daisyaudio/Seed3-DevKit-Pedal/pcb/ES-Seed3-DevKit-Pedal-Rev4/ES-Seed3-DevKit-Pedal-Rev4.kicad_pcb

## KiCad design pcb/ES-Seed3-DevKit-Pedal-Rev4/ES-Seed3-DevKit-Pedal-Rev4.kicad_pcb (2026-06-25)

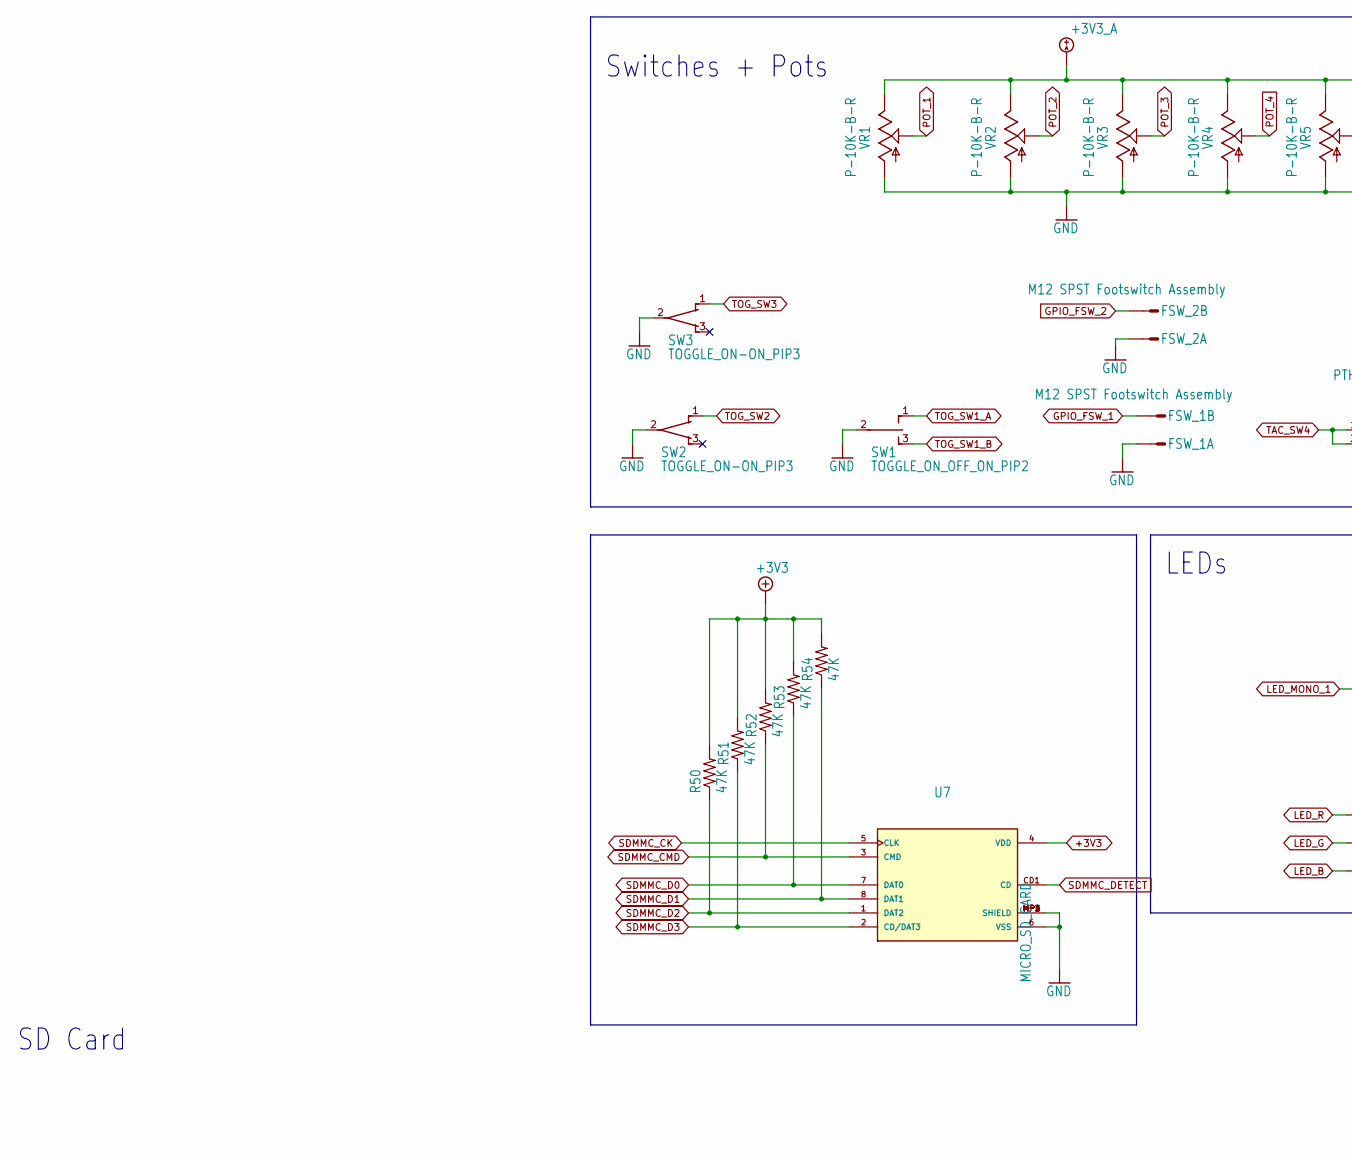
[picture p1: schematic ES-Seed3-DevKit-Pedal-Rev1_2.kicad_sch, part in row 1, column 1]

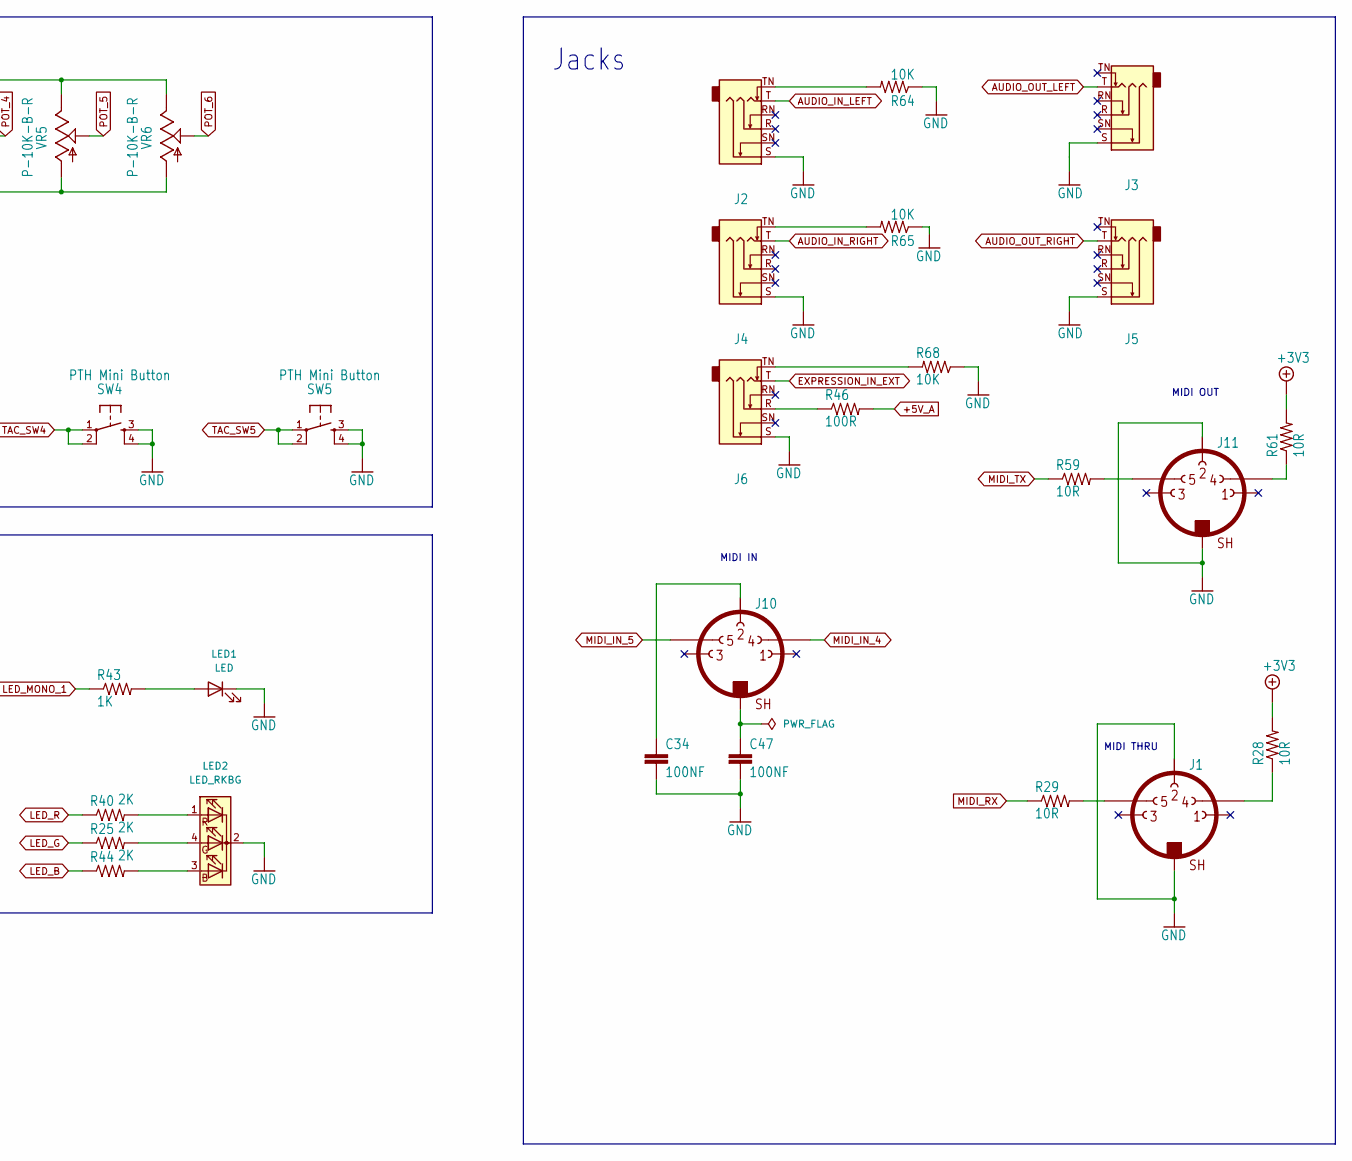
[picture p2: schematic ES-Seed3-DevKit-Pedal-Rev1_2.kicad_sch, part in row 1, column 2]

Parts:
C34, C47: 100NF; C_0603_1608Metric
FSW_1, FSW_2: M12 SPST Footswitch Assembly; S02P
J1, J10, J11: DIN_MIDI_5P; 57PC5F
J2, J3, J4, J5, J6: JACK_TRS_SWITCHING; Jack_6.35mm_Neutrik_NMJ6HCD2_Horizontal
LED1: LED; LED_D5.0mm
LED2: LED_RKBG; LED_D5.0mm-4_RGB_Wide_Pins
R25, R40, R44: 2K; R_0603_1608Metric
R28, R29, R59, R61: 10R; R_0603_1608Metric
R43: 1K; R_0603_1608Metric
R46: 100R; R_0603_1608Metric
R50, R51, R52, R53, R54: 47K; R_0603_1608Metric
R64, R65, R68: 10K; R_0603_1608Metric
SW1: TOGGLE_ON_OFF_ON_PIP2; TOGGLE_ON_OFF_ON
SW2, SW3: TOGGLE_ON-ON_PIP3; TOGGLE_ON_ON_2
SW4, SW5: PTH Mini Button; TL1105SPF250Q_SILK
U7: MICRO_SD_CARD; TF-01A
VR1, VR2, VR3, VR4, VR5, VR6: P-10K-B-R; 9MM_SNAP-IN_POT_SILK

Connections:
+3V3: R28.2, R50.2, R51.2, R52.2, R53.2, R54.2, R61.2, U7.4 (VDD); also elsewhere on the board
+3V3_A: VR1.3, VR2.3, VR3.3, VR4.3, VR5.3, VR6.3; also elsewhere on the board
+5V_A: R46.2; also elsewhere on the board
AUDIO_IN_LEFT: J2.T; also elsewhere on the board
AUDIO_IN_RIGHT: J4.T; also elsewhere on the board
AUDIO_OUT_LEFT: J3.T; also elsewhere on the board
AUDIO_OUT_RIGHT: J5.T; also elsewhere on the board
EXPRESSION_IN_EXT: J6.T; also elsewhere on the board
GND: C34.2, C47.2, FSW_1.1 (S), FSW_2.1 (S), J1.GND1 (PE), J1.GND2 (PE), J1.P2 (2), J2.S, J3.S, J4.S, J5.S, J6.S, J11.GND1 (PE), J11.GND2 (PE), J11.P2 (2), LED1.1 (K), LED2.2 (K), R64.1, R65.1, R68.1, SW1.2, SW2.2, SW3.2, SW4.3, SW4.4, SW5.3, SW5.4, U7.6 (VSS), U7.MP1 (SHIELD), U7.MP2 (SHIELD), U7.MP3 (SHIELD), U7.MP4 (SHIELD), VR1.1, VR2.1, VR3.1, VR4.1, VR5.1, VR6.1; also elsewhere on the board
GPIO_FSW_1: FSW_1.2 (S); also elsewhere on the board
GPIO_FSW_2: FSW_2.2 (S); also elsewhere on the board
LED_B: R44.1; also elsewhere on the board
LED_G: R25.1; also elsewhere on the board
LED_MONO_1: R43.1; also elsewhere on the board
LED_R: R40.1; also elsewhere on the board
MIDI_IN_4: J10.P4 (4); also elsewhere on the board
MIDI_IN_5: J10.P5 (5); also elsewhere on the board
MIDI_RX: R29.1; also elsewhere on the board
MIDI_TX: R59.1; also elsewhere on the board
unnamed: C47.1, J10.GND1 (PE), J10.GND2 (PE)
unnamed: J1.P4 (4), R28.1
unnamed: J1.P5 (5), R29.2
unnamed: J2.TN, R64.2
unnamed: J4.TN, R65.2
unnamed: J6.R, R46.1
unnamed: J6.TN, R68.2
unnamed: C34.1, J10.P2 (2)
unnamed: J11.P4 (4), R61.1
unnamed: J11.P5 (5), R59.2
unnamed: LED1.2 (A), R43.2
unnamed: LED2.3 (BA), R44.2
unnamed: LED2.4 (GA), R25.2
unnamed: LED2.1 (RA), R40.2
POT_1: VR1.2; also elsewhere on the board
POT_2: VR2.2; also elsewhere on the board
POT_3: VR3.2; also elsewhere on the board
POT_4: VR4.2; also elsewhere on the board
POT_5: VR5.2; also elsewhere on the board
POT_6: VR6.2; also elsewhere on the board
SDMMC_CK: U7.5 (CLK); also elsewhere on the board
SDMMC_CMD: R52.1, U7.3 (CMD); also elsewhere on the board
SDMMC_D0: R53.1, U7.7 (DAT0); also elsewhere on the board
SDMMC_D1: R54.1, U7.8 (DAT1); also elsewhere on the board
SDMMC_D2: R50.1, U7.1 (DAT2); also elsewhere on the board
SDMMC_D3: R51.1, U7.2 (CD/DAT3); also elsewhere on the board
SDMMC_DETECT: U7.CD1 (CD); also elsewhere on the board
TAC_SW4: SW4.1, SW4.2; also elsewhere on the board
TAC_SW5: SW5.1, SW5.2; also elsewhere on the board
TOG_SW1_A: SW1.1 (O); also elsewhere on the board
TOG_SW1_B: SW1.3 (S); also elsewhere on the board
TOG_SW2: SW2.1 (O); also elsewhere on the board
TOG_SW3: SW3.1 (O); also elsewhere on the board

Notes on the sheet:
MIDI IN
Jacks
MIDI OUT
Switches + Pots
LEDs
MIDI THRU
SD Card

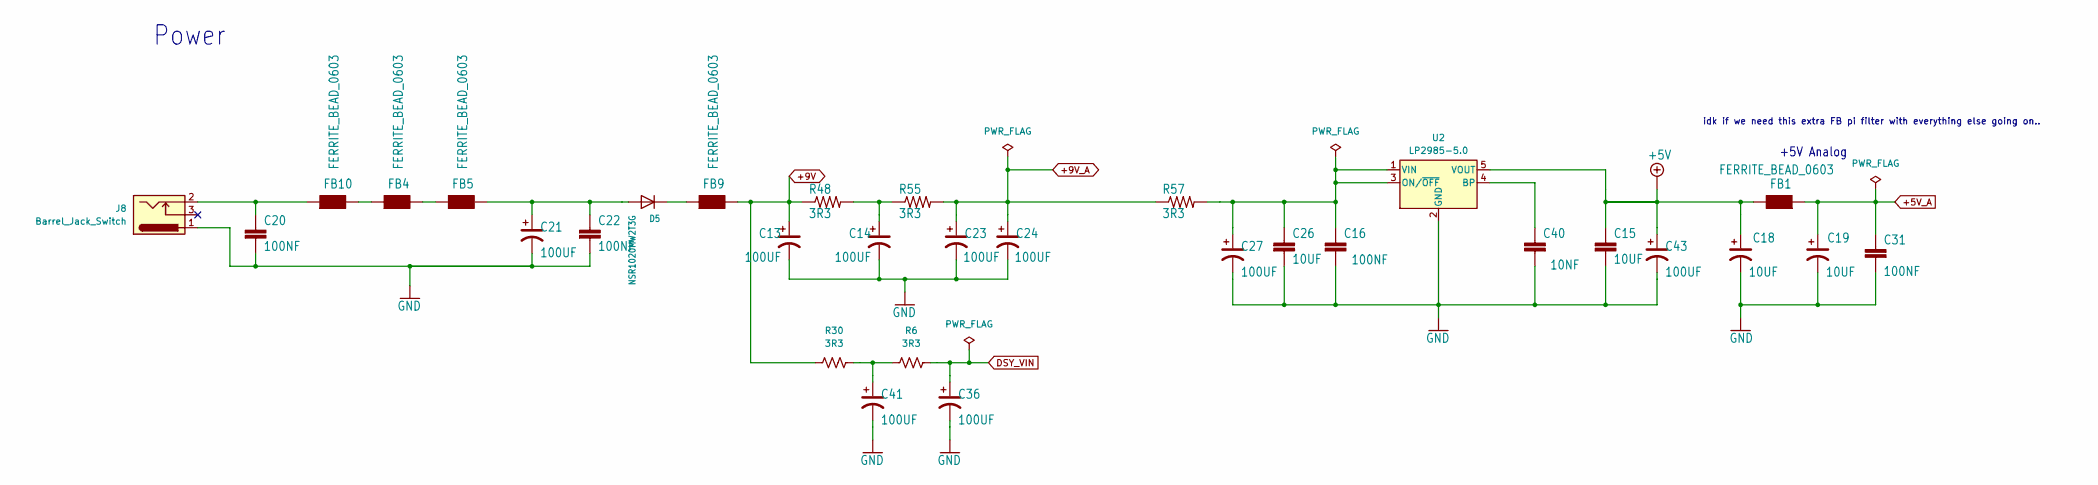
[picture p3: schematic ES-Seed3-DevKit-Pedal-Rev1_4.kicad_sch]

Parts:
C13, C14, C21, C23, C24, C27, C36, C41, C43: 100UF; CP_Elec_6.3x7.7
C15, C26: 10UF; C_0805_2012Metric
C16, C20, C22, C31: 100NF; C_0603_1608Metric
C18, C19: 10UF; CP_Elec_4x5.8
C40: 10NF; C_0603_1608Metric
D5: NSR1020MW2T3G; D_SOD-323
FB1, FB4, FB5, FB9, FB10: FERRITE_BEAD_0603; R_0603_1608Metric
J8: Barrel_Jack_Switch; BarrelJack_Wuerth_6941xx301002
R6, R30, R48, R55, R57: 3R3; R_1206_3216Metric
U2: LP2985-5.0; SOT-23-5

Connections:
+5V: C15.1, C18.1, C43.1, FB1.2, U2.5 (VOUT)
+5V_A: C19.1, C31.1, FB1.1; also elsewhere on the board
+9V: C13.1, FB9.2, R30.1, R48.1
+9V_A: C23.1, C24.1, R55.2, R57.1; also elsewhere on the board
DSY_VIN: C36.1, R6.2; also elsewhere on the board
GND: C13.2, C14.2, C15.2, C16.2, C18.2, C19.2, C20.2, C21.2, C22.2, C23.2, C24.2, C26.2, C27.2, C31.2, C36.2, C40.2, C41.2, C43.2, J8.1, U2.2 (GND); also elsewhere on the board
unnamed: C14.1, R48.2, R55.1
unnamed: C20.1, FB10.1, J8.2
unnamed: C41.1, R6.1, R30.2
unnamed: C21.1, C22.1, D5.2 (A), FB5.2
unnamed: D5.1 (K), FB9.1
unnamed: FB4.2, FB5.1
unnamed: FB4.1, FB10.2
unnamed: C40.1, U2.4 (BP)
unnamed: C16.1, C26.1, C27.1, R57.2, U2.1 (VIN), U2.3 (ON/~OFF)

Notes on the sheet:
idk if we need this extra FB pi filter with everything else going on..
Power
+5V Analog

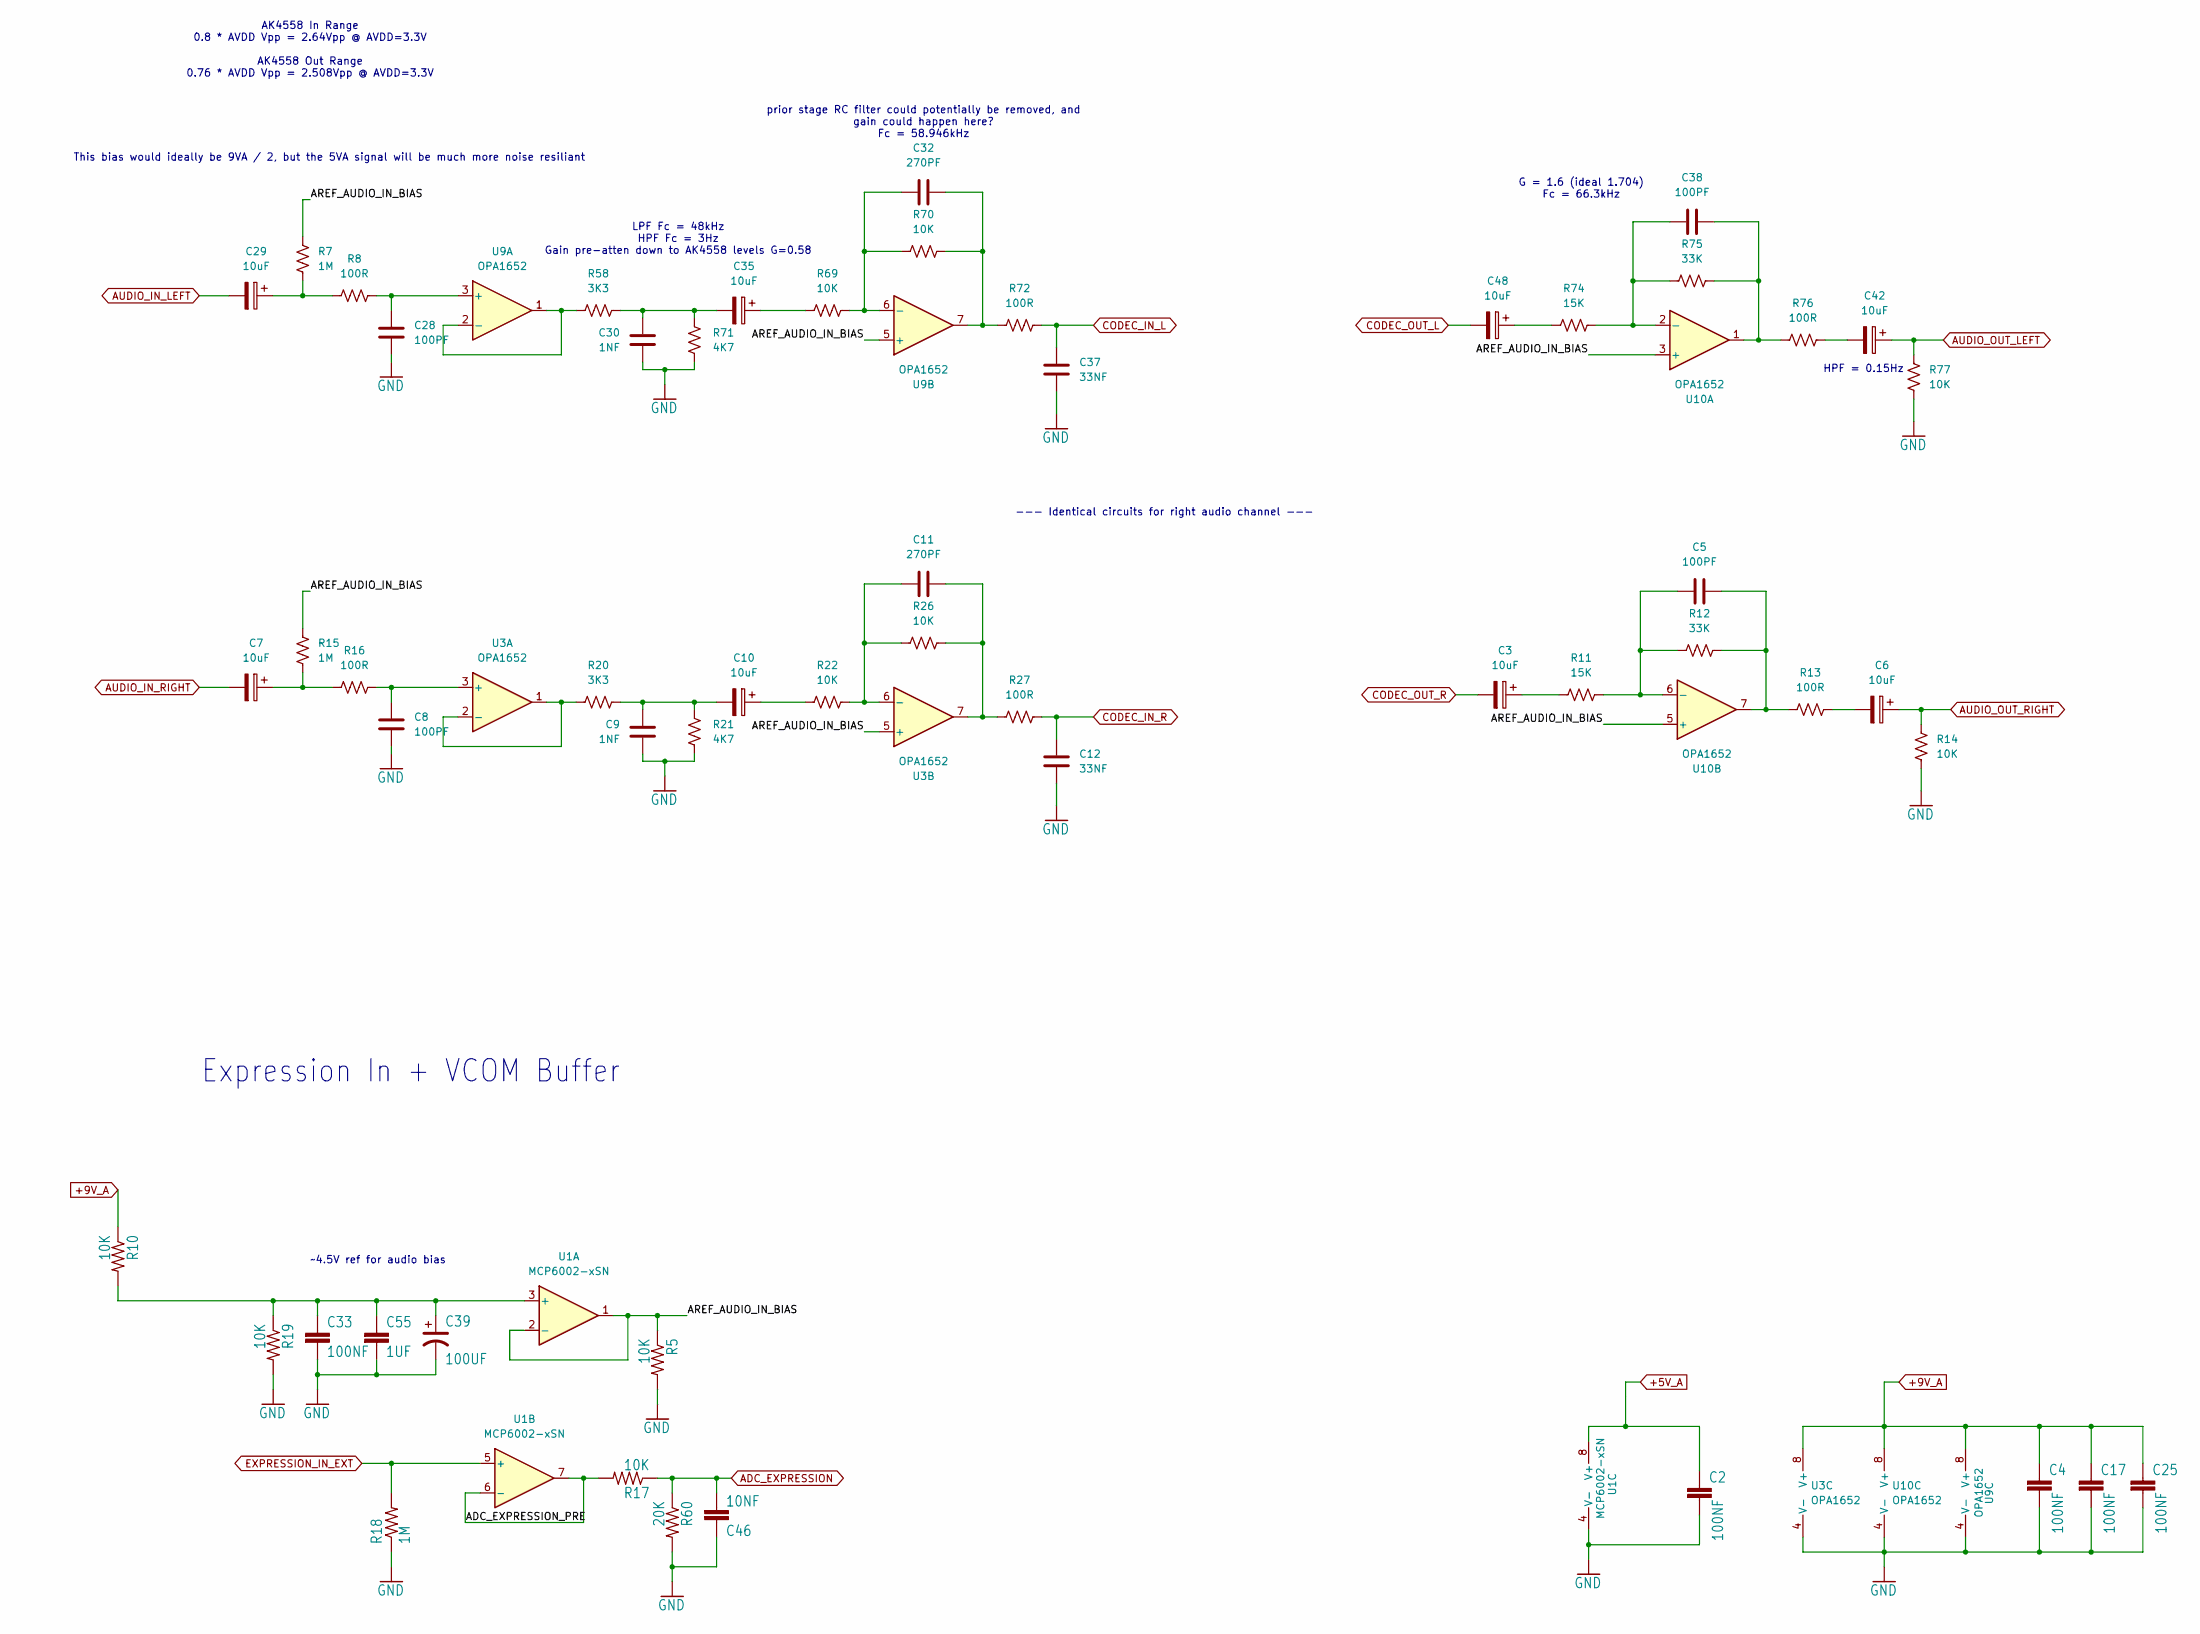
[picture p4: schematic ES-Seed3-DevKit-Pedal-Rev1_3.kicad_sch]

Parts:
C2, C4, C17, C25, C33: 100NF; C_0603_1608Metric
C3, C6, C7, C10, C29, C35, C42, C48: 10uF; CP_Elec_4x5.8
C5, C8, C28, C38: 100PF; C_0603_1608Metric
C9, C30: 1NF; C_0603_1608Metric
C11, C32: 270PF; C_0603_1608Metric
C12, C37: 33NF; C_0603_1608Metric
C39: 100UF; CP_Elec_6.3x7.7
C46: 10NF; C_0603_1608Metric
C55: 1UF; C_0603_1608Metric
R5, R10, R14, R17, R19, R22, R26, R69, R70, R77: 10K; R_0603_1608Metric
R7, R15, R18: 1M; R_0603_1608Metric
R8, R13, R16, R27, R72, R76: 100R; R_0603_1608Metric
R11, R74: 15K; R_0603_1608Metric
R12, R75: 33K; R_0603_1608Metric
R20, R58: 3K3; R_0603_1608Metric
R21, R71: 4K7; R_0603_1608Metric
R60: 20K; R_0603_1608Metric
U1: MCP6002-xSN; SOIC-8_3.9x4.9mm_P1.27mm
U3, U9, U10: OPA1652; SOIC-8_3.9x4.9mm_P1.27mm

Connections:
+5V_A: C2.1, U1.8 (V+); also elsewhere on the board
+9V_A: C4.1, C17.1, C25.1, R10.1, U3.8 (V+), U9.8 (V+), U10.8 (V+); also elsewhere on the board
/Audio IO/ADC_EXPRESSION_PRE: R17.2, U1.6 (-), U1.7
/Audio IO/AREF_AUDIO_IN_BIAS: R5.1, R7.2, R15.2, U1.1, U1.2 (-), U3.5 (+), U9.5 (+), U10.3 (+), U10.5 (+)
ADC_EXPRESSION: C46.2, R17.1, R60.1; also elsewhere on the board
AUDIO_IN_LEFT: C29.2; also elsewhere on the board
AUDIO_IN_RIGHT: C7.2; also elsewhere on the board
AUDIO_OUT_LEFT: C42.1, R77.1; also elsewhere on the board
AUDIO_OUT_RIGHT: C6.1, R14.1; also elsewhere on the board
CODEC_IN_L: C37.2, R72.1; also elsewhere on the board
CODEC_IN_R: C12.2, R27.1; also elsewhere on the board
CODEC_OUT_L: C48.2; also elsewhere on the board
CODEC_OUT_R: C3.2; also elsewhere on the board
EXPRESSION_IN_EXT: R18.2, U1.5 (+); also elsewhere on the board
GND: C2.2, C4.2, C8.2, C9.2, C12.1, C17.2, C25.2, C28.2, C30.2, C33.2, C37.1, C39.2, C46.1, C55.2, R5.2, R14.2, R18.1, R19.2, R21.2, R60.2, R71.2, R77.2, U1.4 (V-), U3.4 (V-), U9.4 (V-), U10.4 (V-); also elsewhere on the board
unnamed: C3.1, R11.2
unnamed: C5.2, R12.1, R13.2, U10.7
unnamed: C6.2, R13.1
unnamed: C7.1, R15.1, R16.2
unnamed: C10.1, R22.2
unnamed: C9.1, C10.2, R20.1, R21.1
unnamed: C11.2, R26.1, R27.2, U3.7
unnamed: C29.1, R7.1, R8.2
unnamed: C30.1, C35.2, R58.1, R71.1
unnamed: C32.2, R70.1, R72.2, U9.7
unnamed: C35.1, R69.2
unnamed: C38.2, R75.1, R76.2, U10.1
unnamed: C42.2, R76.1
unnamed: C48.1, R74.2
unnamed: C33.1, C39.1, C55.1, R10.2, R19.1, U1.3 (+)
unnamed: C8.1, R16.1, U3.3 (+)
unnamed: R20.2, U3.1, U3.2 (-)
unnamed: C11.1, R22.1, R26.2, U3.6 (-)
unnamed: C28.1, R8.1, U9.3 (+)
unnamed: R58.2, U9.1, U9.2 (-)
unnamed: C32.1, R69.1, R70.2, U9.6 (-)
unnamed: C38.1, R74.1, R75.2, U10.2 (-)
unnamed: C5.1, R11.1, R12.2, U10.6 (-)

Notes on the sheet:
G = 1.6 (ideal 1.704) Fc = 66.3kHz
~4.5V ref for audio bias
HPF = 0.15Hz
--- Identical circuits for right audio channel ---
Expression In + VCOM Buffer
AK4558 In Range 0.8 * AVDD Vpp = 2.64Vpp @ AVDD=3.3V AK4558 Out Range 0.76 * AVDD Vpp = 2.508Vpp @ AVDD=3.3V
This bias would ideally be 9VA / 2, but the 5VA signal will be much more noise resiliant
LPF Fc = 48kHz HPF Fc = 3Hz Gain pre-atten down to AK4558 levels G=0.58
prior stage RC filter could potentially be removed, and gain could happen here? Fc = 58.946kHz

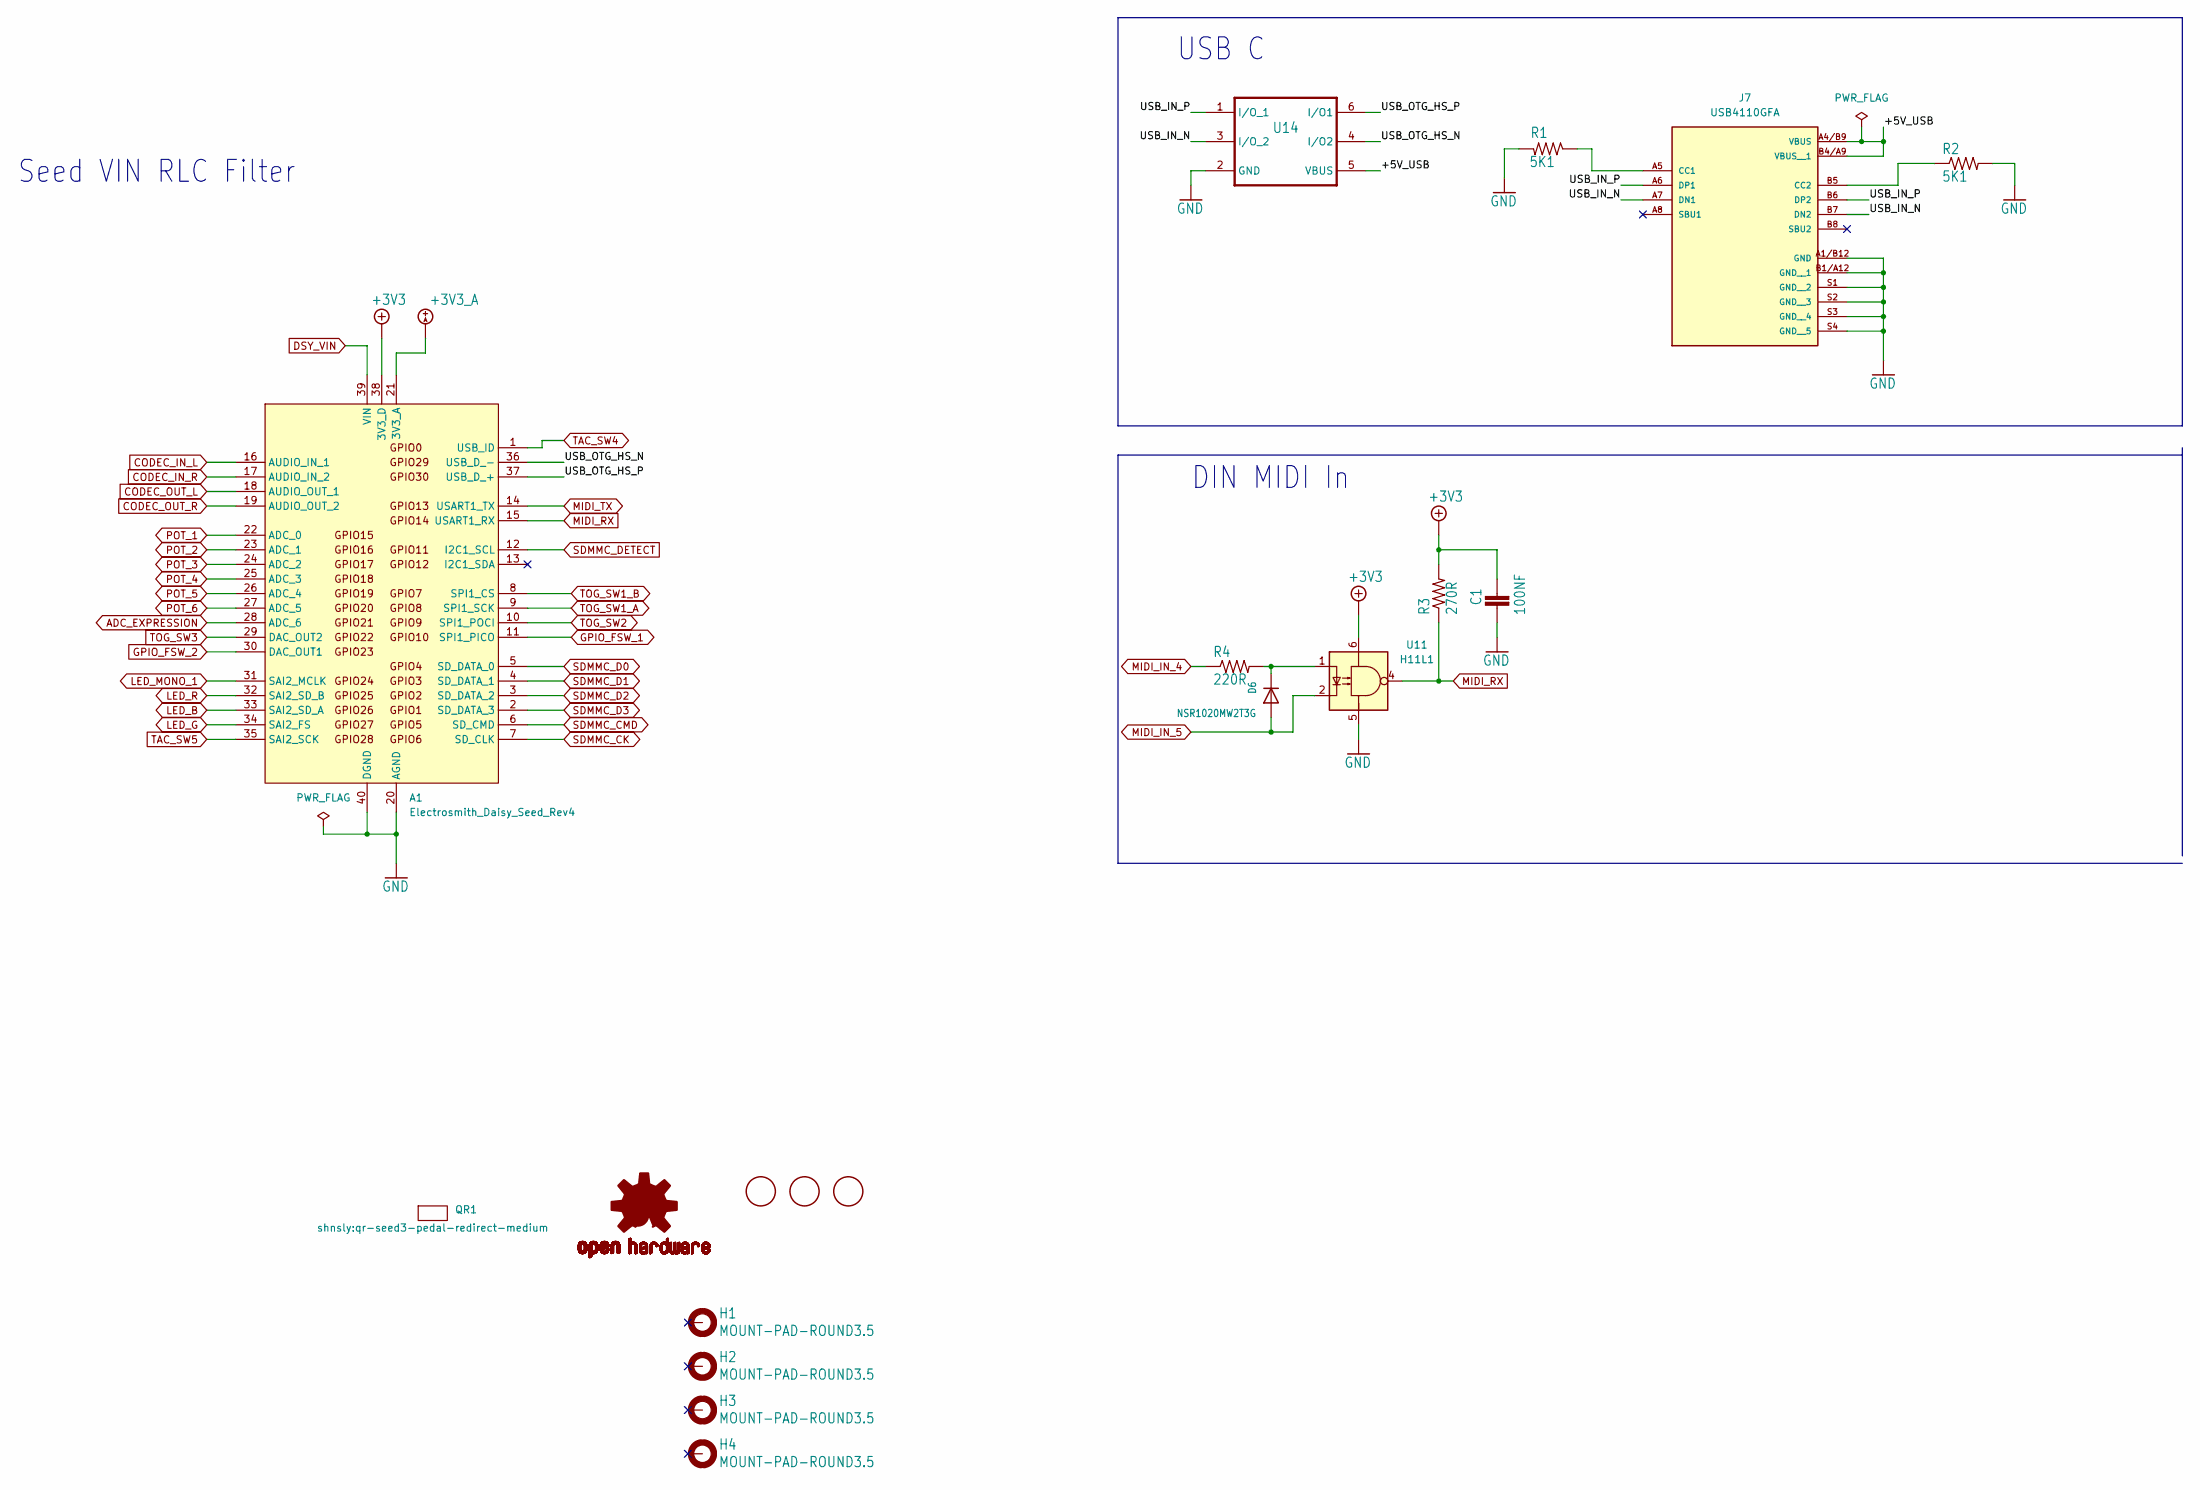
[picture p5: schematic ES-Seed3-DevKit-Pedal-Rev1_1.kicad_sch]

Parts:
A1: Electrosmith_Daisy_Seed_Rev4; Electrosmith_Daisy_Seed
C1: 100NF; C_0603_1608Metric
D6: NSR1020MW2T3G; D_SOD-323
FD1, FD2, FD3: FIDUCIAL; Fiducial_1mm_Mask2mm
H1, H2, H3, H4: MOUNT-PAD-ROUND3.5; MountingHole_3.5mm_Pad
J7: USB4110GFA; GCT_USB4110GFA
LOGO1: OSHW-LOGO; OSHW-Logo2_14.6x12mm_SilkScreen
QR1: qr-seed3-pedal-redirect-medium
R1, R2: 5K1; R_0603_1608Metric
R3: 270R; R_0603_1608Metric
R4: 220R; R_0603_1608Metric
U11: H11L1; DIP-6_W7.62mm
U14: USBLC6-2SC6; SOT-23-6

Connections:
+3V3: A1.38 (3V3_D), C1.2, R3.2, U11.6; also elsewhere on the board
+3V3_A: A1.21 (3V3_A); also elsewhere on the board
/Daisy/+5V_USB: J7.A4/B9 (VBUS), J7.B4/A9 (VBUS__1), U14.5 (VBUS)
/Daisy/USB_IN_N: J7.A7 (DN1), J7.B7 (DN2), U14.3 (I/O_2)
/Daisy/USB_IN_P: J7.A6 (DP1), J7.B6 (DP2), U14.1 (I/O_1)
/Daisy/USB_OTG_HS_N: A1.36 (USB_D_-), U14.4 (I/O2)
/Daisy/USB_OTG_HS_P: A1.37 (USB_D_+), U14.6 (I/O1)
ADC_EXPRESSION: A1.28 (ADC_6); also elsewhere on the board
CODEC_IN_L: A1.16 (AUDIO_IN_1); also elsewhere on the board
CODEC_IN_R: A1.17 (AUDIO_IN_2); also elsewhere on the board
CODEC_OUT_L: A1.18 (AUDIO_OUT_1); also elsewhere on the board
CODEC_OUT_R: A1.19 (AUDIO_OUT_2); also elsewhere on the board
DSY_VIN: A1.39 (VIN); also elsewhere on the board
GND: A1.20 (AGND), A1.40 (DGND), C1.1, J7.A1/B12 (GND), J7.B1/A12 (GND__1), J7.S1 (GND__2), J7.S2 (GND__3), J7.S3 (GND__4), J7.S4 (GND__5), R1.2, R2.2, U11.5, U14.2 (GND); also elsewhere on the board
GPIO_FSW_1: A1.11 (SPI1_PICO); also elsewhere on the board
GPIO_FSW_2: A1.30 (DAC_OUT1); also elsewhere on the board
LED_B: A1.33 (SAI2_SD_A); also elsewhere on the board
LED_G: A1.34 (SAI2_FS); also elsewhere on the board
LED_MONO_1: A1.31 (SAI2_MCLK); also elsewhere on the board
LED_R: A1.32 (SAI2_SD_B); also elsewhere on the board
MIDI_IN_4: R4.1; also elsewhere on the board
MIDI_IN_5: D6.2 (A), U11.2; also elsewhere on the board
MIDI_RX: A1.15 (USART1_RX), R3.1, U11.4; also elsewhere on the board
MIDI_TX: A1.14 (USART1_TX); also elsewhere on the board
unnamed: D6.1 (K), R4.2, U11.1
unnamed: J7.A5 (CC1), R1.1
unnamed: J7.B5 (CC2), R2.1
POT_1: A1.22 (ADC_0); also elsewhere on the board
POT_2: A1.23 (ADC_1); also elsewhere on the board
POT_3: A1.24 (ADC_2); also elsewhere on the board
POT_4: A1.25 (ADC_3); also elsewhere on the board
POT_5: A1.26 (ADC_4); also elsewhere on the board
POT_6: A1.27 (ADC_5); also elsewhere on the board
SDMMC_CK: A1.7 (SD_CLK); also elsewhere on the board
SDMMC_CMD: A1.6 (SD_CMD); also elsewhere on the board
SDMMC_D0: A1.5 (SD_DATA_0); also elsewhere on the board
SDMMC_D1: A1.4 (SD_DATA_1); also elsewhere on the board
SDMMC_D2: A1.3 (SD_DATA_2); also elsewhere on the board
SDMMC_D3: A1.2 (SD_DATA_3); also elsewhere on the board
SDMMC_DETECT: A1.12 (I2C1_SCL); also elsewhere on the board
TAC_SW4: A1.1 (USB_ID); also elsewhere on the board
TAC_SW5: A1.35 (SAI2_SCK); also elsewhere on the board
TOG_SW1_A: A1.9 (SPI1_SCK); also elsewhere on the board
TOG_SW1_B: A1.8 (SPI1_CS); also elsewhere on the board
TOG_SW2: A1.10 (SPI1_POCI); also elsewhere on the board
TOG_SW3: A1.29 (DAC_OUT2); also elsewhere on the board

Notes on the sheet:
Seed VIN RLC Filter
USB C
DIN MIDI In

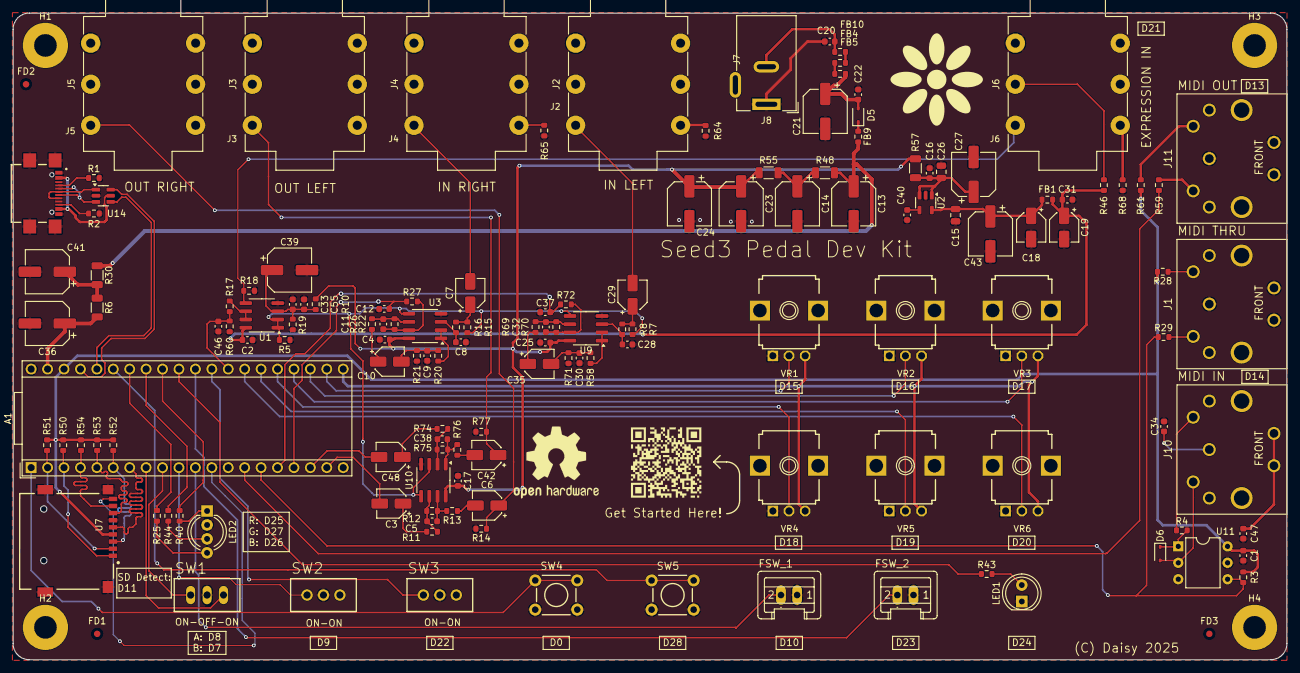
[picture p6: board ES-Seed3-DevKit-Pedal-Rev4.kicad_pcb from above]

Board: 2 copper layers, 197.0 x 100.0 mm, 151 parts (0 on the bottom side), 103 nets.
